PP-Phil/Embedded_competition/README.md

# Embedded_competition
第七届全国大学生嵌入式芯片与系统设计竞赛全国一等奖和ST杯-新能源汽车无线充电系统
实物演示观看地址https://www.bilibili.com/video/BV1TNeYeEEZz/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
