PP-Phil/Embedded_competition/Lifting_platform.STEP

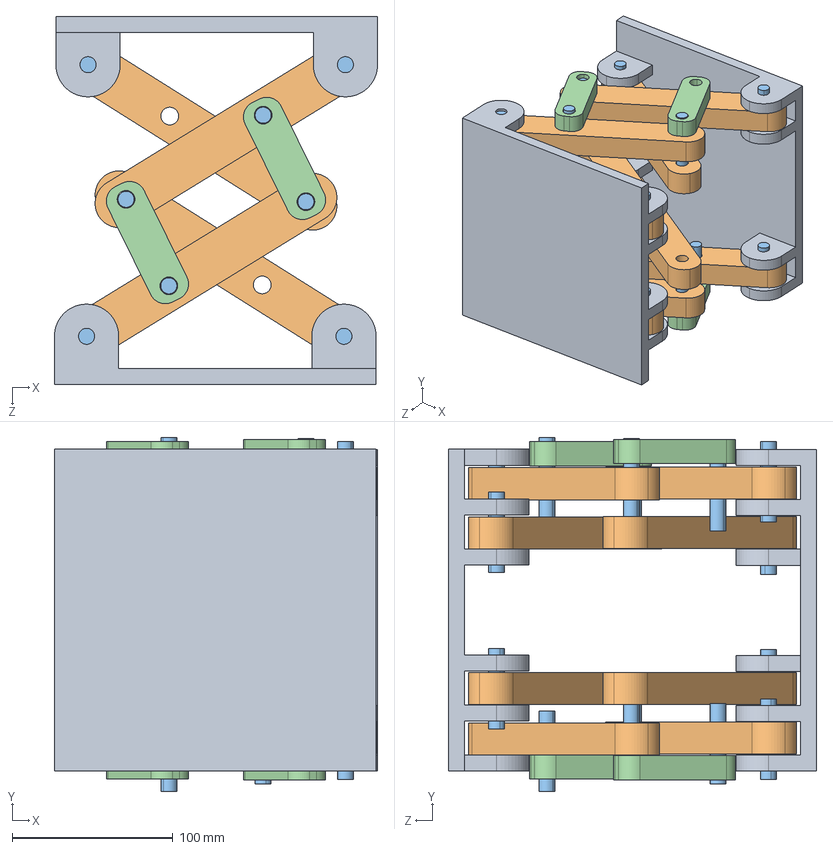
[picture p34: CAD file, 2024-08-18]
Lifting_platform.STEP
200.9 x 220.1 x 228.8 mm
pedestal.step x 2
long_pole.step x 8
蹟佪.step x 16
short_pole.step x 4
